micthiesen/key-right/docs/references/photos/keylight-3624.png

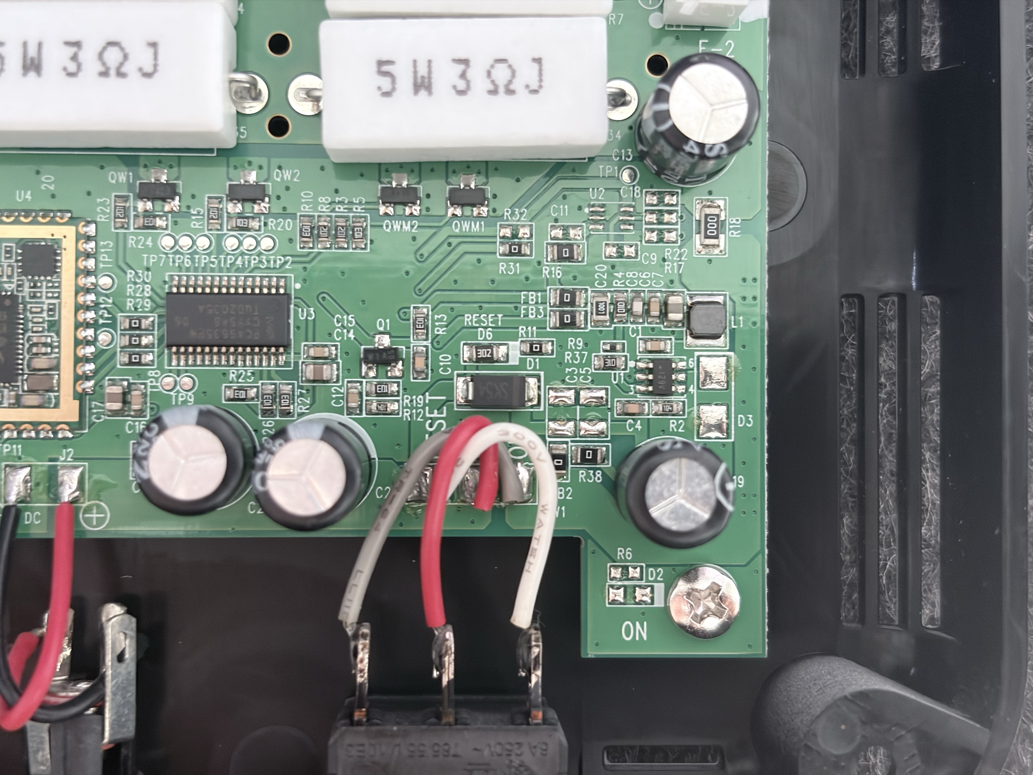
docs/references/photos/keylight-3624.png
