micthiesen/key-right/docs/references/photos/keylight-j6-detail.png

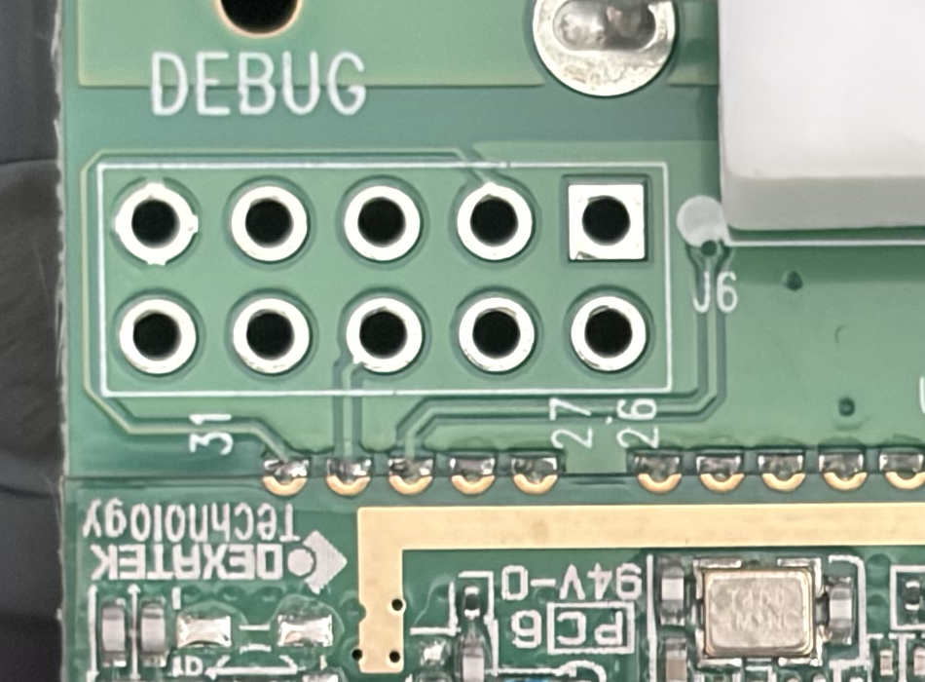
docs/references/photos/keylight-j6-detail.png
