micthiesen/key-right/docs/field-guides/off-glow/key-right-resistor-trial.pdf

KEY RIGHT / FIELD GUIDE

# Off-glow resistor trial

2 × 10 kΩ axial resistors · ¼ W minimum · one lamp first

UNPLUG LAMP POWER + USB BEFORE SOLDERING

COMPONENT SIDE | White power resistors at top

A F-1 / J1

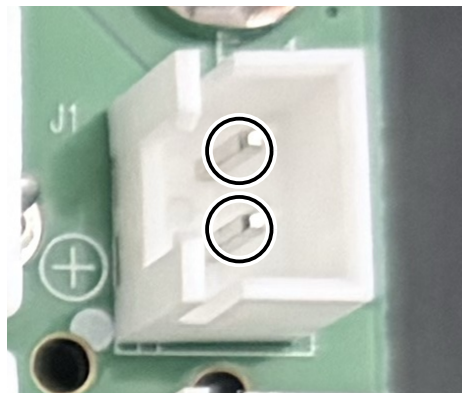
[picture p5: figure]

Upper right connector

B F-2 / J3

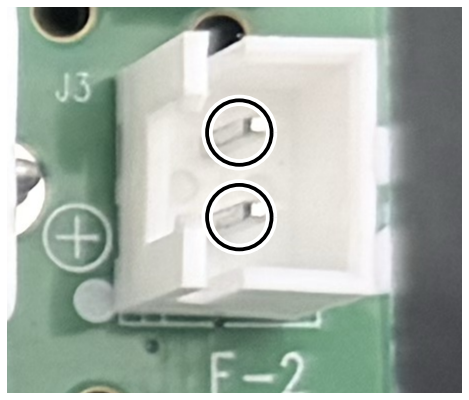
[picture p6: figure]

Lower right, above capacitor

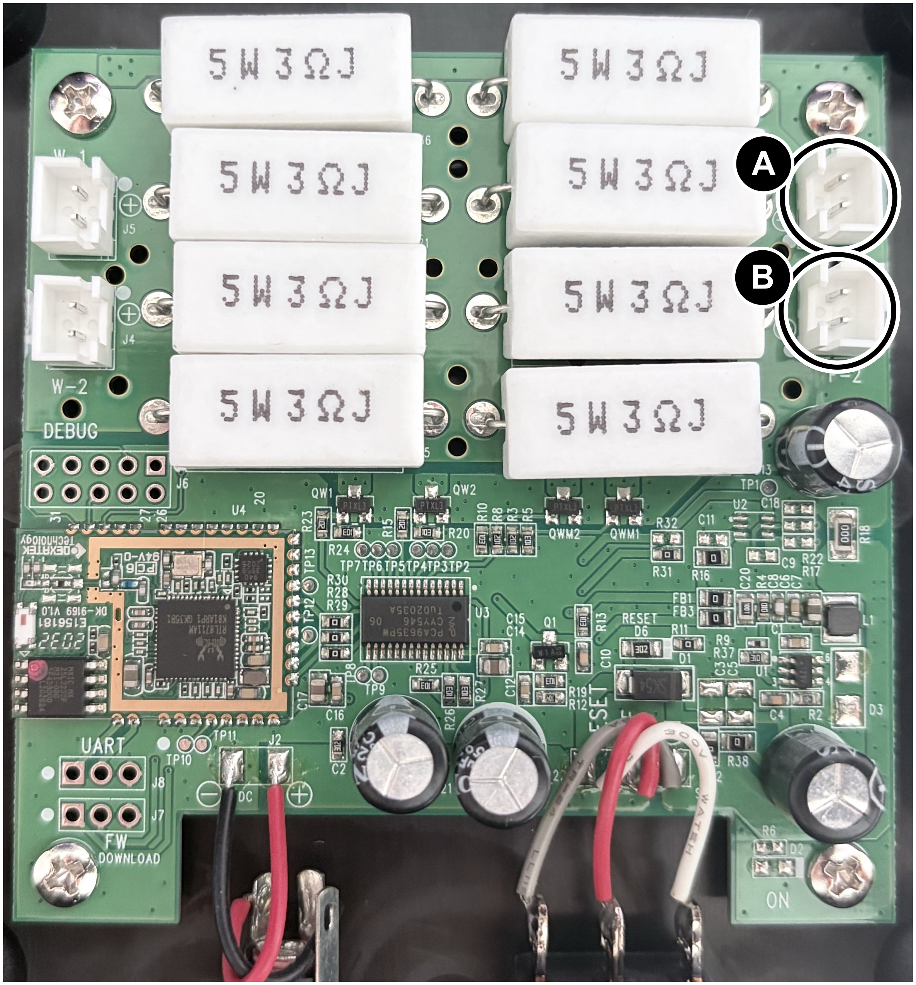
[picture p7: figure]

Original board photo; DC input wires at bottom.

ONE RESISTOR ACROSS EACH CONNECTOR

One lead to each circled contact's solder pad. Either direction.
The underside pads are not shown; follow the two connector pins. Keep panel wires connected normally. Insulate exposed resistor leads. Leave W-1/W-2 unchanged. Do not connect to GND, OE or the ESP.

WHILE OPEN: FLASH PREPARED FIRMWARE 0.1.4 Lamp/bench power + VBUS-blocked USB. Preserve NVS / Home pairing. Check settled Off with status, registers and verify before fitting parts.
If PWM is nonzero or a fault appears, fix that before adding resistors.

Reassemble with power removed. Then check fades, low brightness and Off in a dark room. This is a trial; the glow fix is not yet proven.

29 SEP 2026 · Contact reference, not an underside pad map
