micthiesen/key-right/docs/field-guides/off-glow/assets/axial-resistor.png

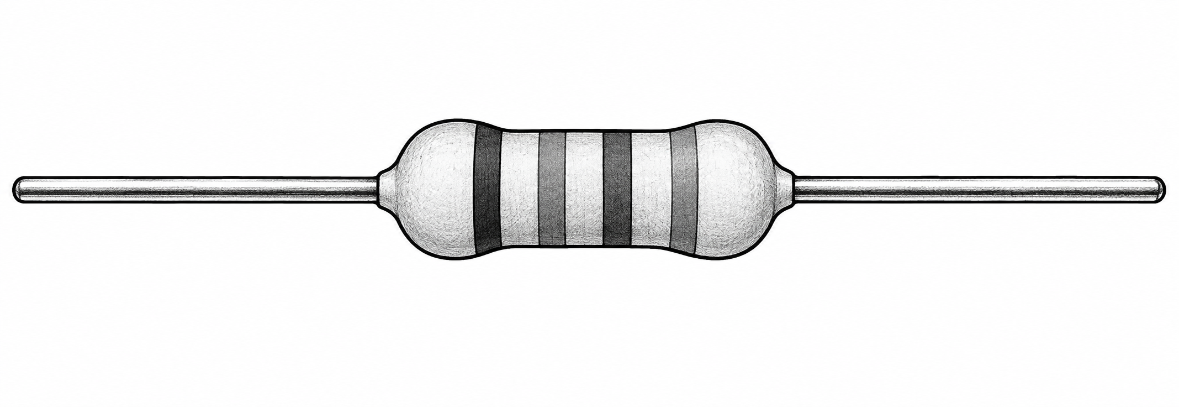
docs/field-guides/off-glow/assets/axial-resistor.png
