micthiesen/key-right/firmware/app/src/device.rs

//! ESP32-C3_MINI_V1 controlling the retained stock PCA9635 over I2C.
#![no_std]
#![no_main]
use esp_backtrace as _;
use esp_hal::gpio::{DriveMode, Level, Output, OutputConfig};
use esp_hal::i2c::master::{BusTimeout, Config as I2cConfig, I2c, SoftwareTimeout};
use esp_hal::ram;
use esp_hal::time::{Duration, Rate};
use esp_hal::timer::timg::TimerGroup;
use esp_hal::usb::usb_serial_jtag::UsbSerialJtag;
use esp_metadata_generated::memory_range;
use tinyrlibc as _;

mod boot;
mod commissioning;
mod commissioning_ble;
mod console;
mod device_matter;
mod hardware;
mod network;
mod network_driver;
mod network_scan;
mod network_tx;
mod ota;
mod ota_health;
mod output;
mod presets;
mod recovery;
mod runtime;
mod storage;

// esp-lan-ota accepts only images whose project name matches this one, so a
// lamp refuses the simulated `key-right-bench` image.
esp_bootloader_esp_idf::esp_app_desc!(
    env!("CARGO_PKG_VERSION"),
    "key-right",
    esp_bootloader_esp_idf::BUILD_TIME,
    esp_bootloader_esp_idf::BUILD_DATE,
    esp_bootloader_esp_idf::ESP_IDF_COMPATIBLE_VERSION,
    esp_bootloader_esp_idf::MMU_PAGE_SIZE,
    0,
    u16::MAX,
    esp_bootloader_esp_idf::SECURE_VERSION
);

// Same split as the pinned SDK's persistent Wi-Fi example: reclaim RAM that
// the second-stage bootloader no longer needs without reducing the radio heap.
const HEAP_SIZE: usize = 100 * 1024;
const RECLAIMED_RAM: usize =
    memory_range!("DRAM2_UNINIT").end - memory_range!("DRAM2_UNINIT").start;

#[esp_rtos::main]
async fn main(spawner: embassy_executor::Spawner) {
    output::init();
    let p = esp_hal::init(esp_hal::Config::default());
    // Output::new sets the latch HIGH before configuring/enabling the output.
    // The existing ~10 kΩ pull-up releases OE; HIGH is not a POR-off guarantee.
    let oe = Output::new(
        p.GPIO6,
        Level::High,
        OutputConfig::default().with_drive_mode(DriveMode::OpenDrain),
    );
    let bus = I2c::new(
        p.I2C0,
        I2cConfig::default()
            .with_frequency(Rate::from_khz(100))
            .with_timeout(BusTimeout::BusCycles(1000))
            .with_software_timeout(SoftwareTimeout::Transaction(Duration::from_millis(25))),
    )
    .expect("100 kHz I2C configuration")
    .with_sda(p.GPIO4)
    .with_scl(p.GPIO5);
    esp_alloc::heap_allocator!(size: HEAP_SIZE - RECLAIMED_RAM);
    esp_alloc::heap_allocator!(#[ram(reclaimed)] size: RECLAIMED_RAM);
    let timg0 = TimerGroup::new(p.TIMG0);
    let software_interrupt =
        esp_hal::interrupt::software::SoftwareInterruptControl::new(p.SW_INTERRUPT);
    esp_rtos::start(timg0.timer0, software_interrupt.software_interrupt0);
    let mut watchdog = timg0.wdt;
    watchdog.set_timeout(
        esp_hal::timer::timg::MwdtStage::Stage0,
        Duration::from_secs(15),
    );
    watchdog.enable();
    let (rx, tx) = UsbSerialJtag::new(p.USB_DEVICE).into_async().split();
    spawner.spawn(output::writer_task(tx).expect("USB writer"));
    log::warn!(
        "Key Right hardware mode; reset={:?}; no physical light acknowledgement is claimed",
        esp_hal::system::reset_reason()
    );
    let mut hardware = hardware::PhysicalOutput::new(bus, oe);
    // Try stock zero-PWM before Matter initialization. A PCA fault must not
    // prevent USB diagnostics on the bench.
    use runtime::Hardware as _;
    let _ = hardware.shutdown();
    device_matter::run(
        (p.RNG, p.ADC1),
        p.WIFI,
        p.BT,
        p.FLASH,
        hardware,
        rx,
        watchdog,
    )
    .await;
}
