micthiesen/key-right/firmware/app/host-tests/src/recovery_tests.rs

use crate::ota_health::{ota_verdict, OtaVerdict, OTA_CONFIRM_DEADLINE_MS, OTA_HEALTHY_MS};
use crate::recovery::{
    usable_local_ipv6, AssociatedHealth, DriverErrors, LocalNetHealth, RestartBackoff,
};

#[test]
fn local_readiness_requires_an_operational_unicast_ipv6_address() {
    use core::net::Ipv6Addr;
    let local = "fe80::1234".parse().unwrap();
    assert!(usable_local_ipv6(true, &[local]));
    assert!(!usable_local_ipv6(false, &[local]));
    // An IPv4 address is insufficient when the IPv6 list is empty.
    assert!(!usable_local_ipv6(true, &[]));
    assert!(!usable_local_ipv6(
        true,
        &[
            Ipv6Addr::UNSPECIFIED,
            Ipv6Addr::LOCALHOST,
            "ff02::1".parse().unwrap(),
        ]
    ));
    assert!(usable_local_ipv6(true, &[Ipv6Addr::UNSPECIFIED, local]));
}

#[test]
fn internal_driver_errors_recreate_after_three_consecutive_failures() {
    let mut errors = DriverErrors::default();
    assert!(!errors.observe(true));
    assert!(!errors.observe(true));
    assert!(errors.observe(true));
    for _ in 0..300 {
        assert!(errors.observe(true));
    }
    assert!(!errors.observe(false));
    assert!(!errors.observe(true));
}

#[test]
fn expected_association_failures_and_success_break_internal_error_streaks() {
    let mut errors = DriverErrors::default();
    for _ in 0..100 {
        assert!(!errors.observe(true));
        assert!(!errors.observe(true));
        // An absent AP or a successful operation must prevent escalation.
        assert!(!errors.observe(false));
    }
}

#[test]
fn associated_radio_queries_must_fail_continuously_for_a_minute() {
    let mut health = AssociatedHealth::default();
    assert!(!health.restart_due(100, true, false));
    assert!(!health.restart_due(60_099, true, false));
    assert!(health.restart_due(60_100, true, false));
    assert!(!health.restart_due(60_101, true, true));
    assert!(!health.restart_due(120_101, true, false));
    assert!(!health.restart_due(120_102, false, false));
    assert!(!health.restart_due(999_999, false, false));
    assert!(!health.restart_due(1_000_000, true, false));
    assert!(health.restart_due(1_060_000, true, false));
}

#[test]
fn ipv6_loss_after_a_healthy_period_recovers_but_disassociation_is_idle() {
    let mut health = LocalNetHealth::default();
    assert!(!health.restart_due(0, true, true));
    assert!(!health.restart_due(10_000, true, false));
    assert!(!health.restart_due(69_999, true, false));
    assert!(health.restart_due(70_000, true, false));
    assert!(!health.restart_due(70_001, false, false));
    assert!(!health.restart_due(1_000_000, false, false));
    assert!(!health.restart_due(1_000_001, true, false));
    assert!(!health.restart_due(1_059_999, true, true));
}

#[test]
fn transport_restart_backoff_is_capped_and_only_healthy_operation_resets_it() {
    let mut backoff = RestartBackoff::default();
    for expected in [5, 10, 20, 40, 60, 60, 60] {
        assert_eq!(backoff.next_delay_secs(0), expected);
    }
    for _ in 0..300 {
        assert_eq!(backoff.next_delay_secs(119_999), 60);
    }
    assert_eq!(backoff.next_delay_secs(120_000), 5);
    assert_eq!(backoff.next_delay_secs(0), 10);
    assert_eq!(backoff.next_delay_secs(600_000), 5);
}

#[test]
fn updated_image_confirms_only_with_matter_network_and_output_evidence() {
    let verified = || true;
    assert_eq!(
        ota_verdict(40_000, true, OTA_HEALTHY_MS, verified),
        OtaVerdict::Confirm
    );
    // Late but healthy evidence still confirms rather than rolling back.
    assert_eq!(
        ota_verdict(OTA_CONFIRM_DEADLINE_MS, true, 600_000, verified),
        OtaVerdict::Confirm
    );
    for (commissioned, healthy_ms) in [(false, 600_000), (true, OTA_HEALTHY_MS - 1)] {
        assert_eq!(
            ota_verdict(
                OTA_CONFIRM_DEADLINE_MS - 1,
                commissioned,
                healthy_ms,
                || { panic!("output readback waits for Matter and network evidence") }
            ),
            OtaVerdict::Wait
        );
        assert_eq!(
            ota_verdict(OTA_CONFIRM_DEADLINE_MS, commissioned, healthy_ms, verified),
            OtaVerdict::RollBack
        );
    }
    assert_eq!(
        ota_verdict(60_000, true, 600_000, || false),
        OtaVerdict::Wait
    );
    assert_eq!(
        ota_verdict(OTA_CONFIRM_DEADLINE_MS, true, 600_000, || false),
        OtaVerdict::RollBack
    );
}
