micthiesen/key-right/(commit log)

2026-09-22 Document ESP32 Key Light replacement plan
2026-09-23 Set up Rust firmware with Stillair Matter connectivity
    [partitions.csv]
2026-09-23 Add real light control and a printable assembly guide
2026-09-23 Support Rust 1.98 and record completed guide printing
2026-09-23 Record passing CI and completed simplified guide print [skip ci]
2026-09-29 Reconcile spec with installed C3 wiring and bench status
2026-09-29 Port Key Right to C3 with one dimmable temperature light
    [partitions.csv]
2026-09-29 Fix C3 startup panic by sizing the Matter transport arena
    [device_matter.rs]
2026-09-29 Record SDA and SCL bench voltage readings
2026-09-29 Withdraw incorrect field-guide signal wiring map
2026-09-29 Record first board rework and pending USB reconnection
2026-09-29 Record USB recovery attempts after wiring correction
2026-09-29 Record successful PCA bench checks after wiring repair
2026-09-29 Record verified Off and On OE voltage levels
2026-09-29 Record unloaded LED connector Off readings
2026-09-29 Record unloaded LED connector On readings
2026-09-29 Bound Matter Wi-Fi scan replies to avoid packet overflow
    [device.rs, lib.rs, main.rs, network.rs, network_scan.rs, network_scan_tests.rs]
2026-09-29 Fix repeated Matter transport startup and subscription capacity
    [commissioning_ble_tests.rs, device_matter.rs, lib.rs]
2026-09-29 Accept final Home controls and release first board for assembly
2026-09-29 Record second-board flash and driver verification
2026-09-29 Accept second-board Home controls and record both lamp states
2026-09-29 Specify 10k warm-output bleeder trial and connector pins
2026-09-29 Add illustrated resistor trial field guide
2026-09-29 Record completed field guide print
2026-09-29 Record board A firmware 0.1.4 flash and reboot checks
2026-09-29 Record assembled operation and partial off-glow improvement
2026-10-12 Add Matter-delivered OTA updates via esp-lan-ota
    Firmware 0.1.5 (software version 6). The real key-right image carries the
    esp-lan-ota cluster (rev 9b6df67) on light endpoint 1, opens the enrollment
    window after a USB flash, reboots into staged updates through the normal
    verified-zero reboot, and confirms a new image only when commissioned, with
    30 s of current Wi-Fi/IPv6 health and passing PCA readback. Otherwise it
    resets unconfirmed after 5 minutes so the bootloader rolls back.
    The partition table moves to otadata plus two 0x1F0000 slots with nvs
    unchanged at 0x9000/0x10000. The flash helper validates that layout, checks
    image fit in ota_0, writes the vendored rollback bootloader, target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
